reedb/encoder_AMC_GERBER_F/README.md

Generate a schematic for the Solectria motor speed encoder (labeled AMC_GERBER_F on PCB) in CADSOFT Eagle format.
