reedb/encoder_AMC_GERBER_F/AMC_GERBER_F_SCH_2.png

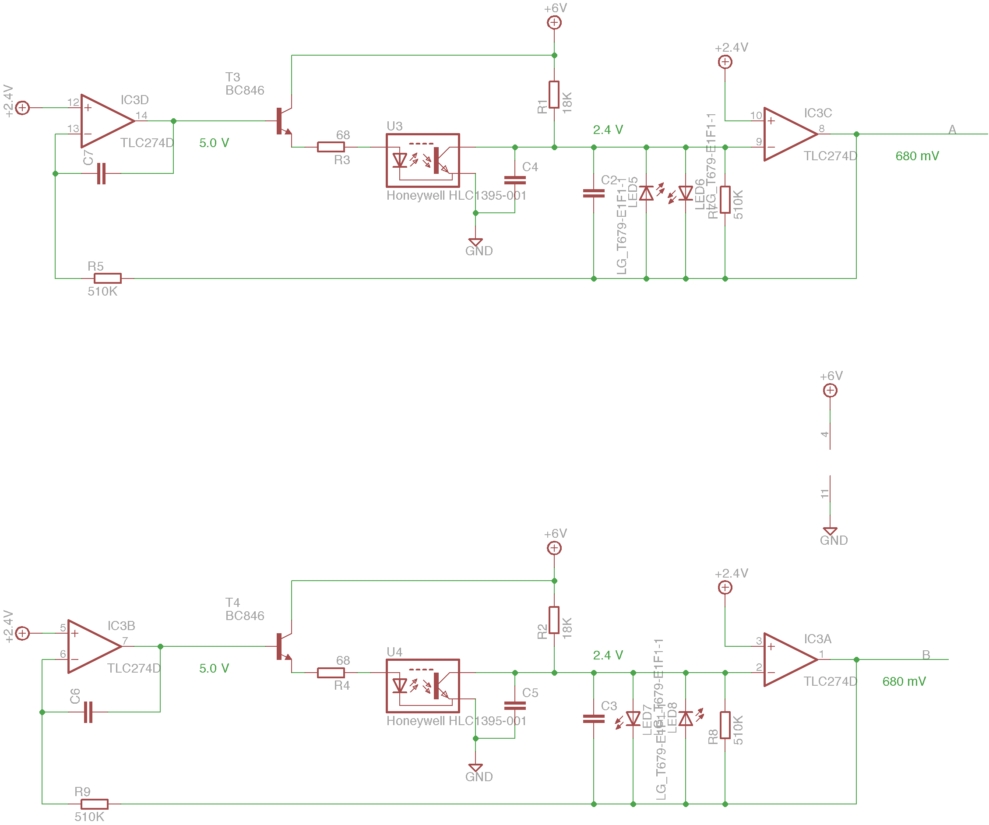
AMC_GERBER_F_SCH_2.png
