reedb/encoder_AMC_GERBER_F/AMC_GERBER_F_SS.png

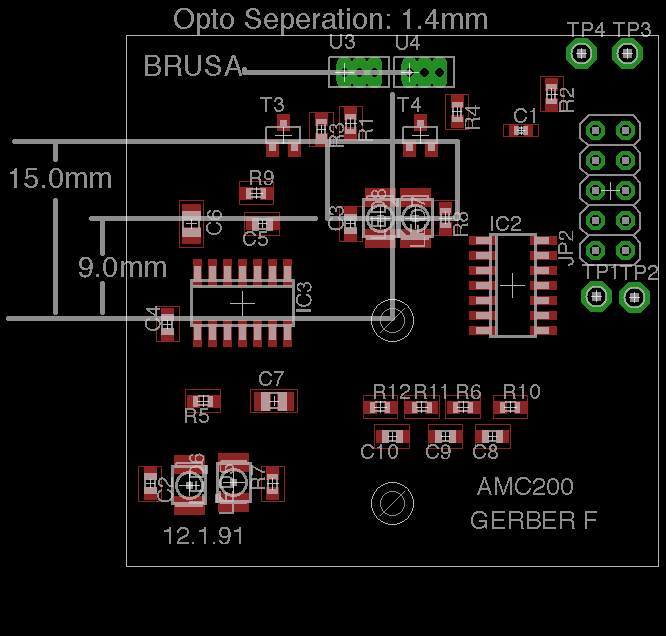
AMC_GERBER_F_SS.png
