reedb/encoder_AMC_GERBER_F/simulator.png

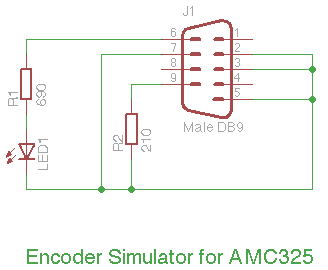
simulator.png
