reedb/encoder_AMC_GERBER_F/troubleshooting_notes.txt

Parts:

TI TLC274 Quad OPAMP - TLC274ID (SO-14, 10mv Voffset, -40 to 85 deg C)
NATIONAL LM2901D Low power quad voltage comparator (SO-14)
NXP BC846B Bipolar Transistor 65 V, 100 mA NPN , SOT-23
Honeywell HLC1395-001 Optoswitch

Header    DBM-9       Description
1         -           Shield
2         1           Test Point
3         6           +6VDC
4         2           Gnd
5         7           B-     Lo
6         3           A-     Lo
7         8           B+     Hi
8         4           A+     Hi
9         9           Motor Temp (240 ohm to Gnd @ 70 degree F)
10        5           Gnd

If your speed sensor is not working:

1. Check if the the black and white disk is scratched. The sensor is VERY 
sensitive to scratches. Wear in the motor bearings can cause the encoder 
disk to contact the opto-switches causing damage to both.

2. Check your connectors, there are a lot in the encoder path, none of which 
are rated for an automotive environment.

3. Check the rotation sense select switch in the motor controller. The encoder 
signal is routed through it.

4. Check LED's on encoder board for operation with power applied and encoder 
disk spinning. These are very faint but can be seen in the dark.

5. Check that the motor controller reports the correct encoder signals (GZ*) 
if you have amcmon.exe connected to the motor controller serial port.
